smdjeff/pinball-dr-who-wobblehead/README.md

# Dr Who Pinball Moving Dalek Wobble Head Kit

<table><tr>
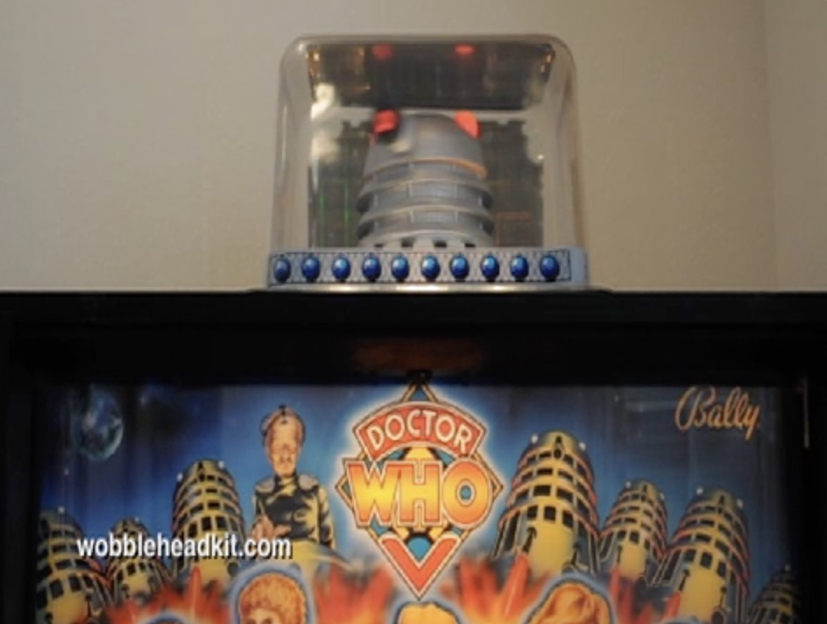
[picture p1: docs/topper.jpg]
    <td style="center"></td>
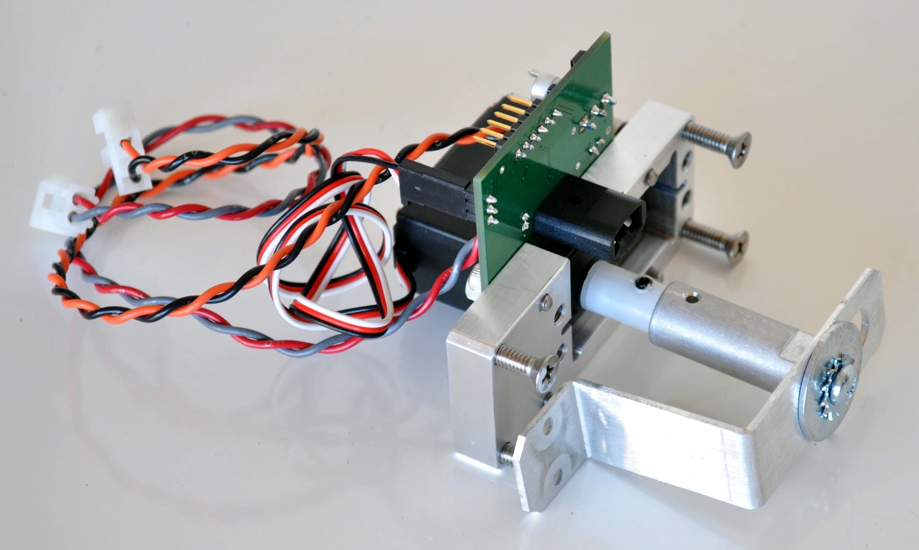
[picture p2: docs/kit.jpeg]
    <td style="center"></td>
</tr></table>
