smdjeff/pinball-dr-who-wobblehead/mechanical/MFP_70267.pdf

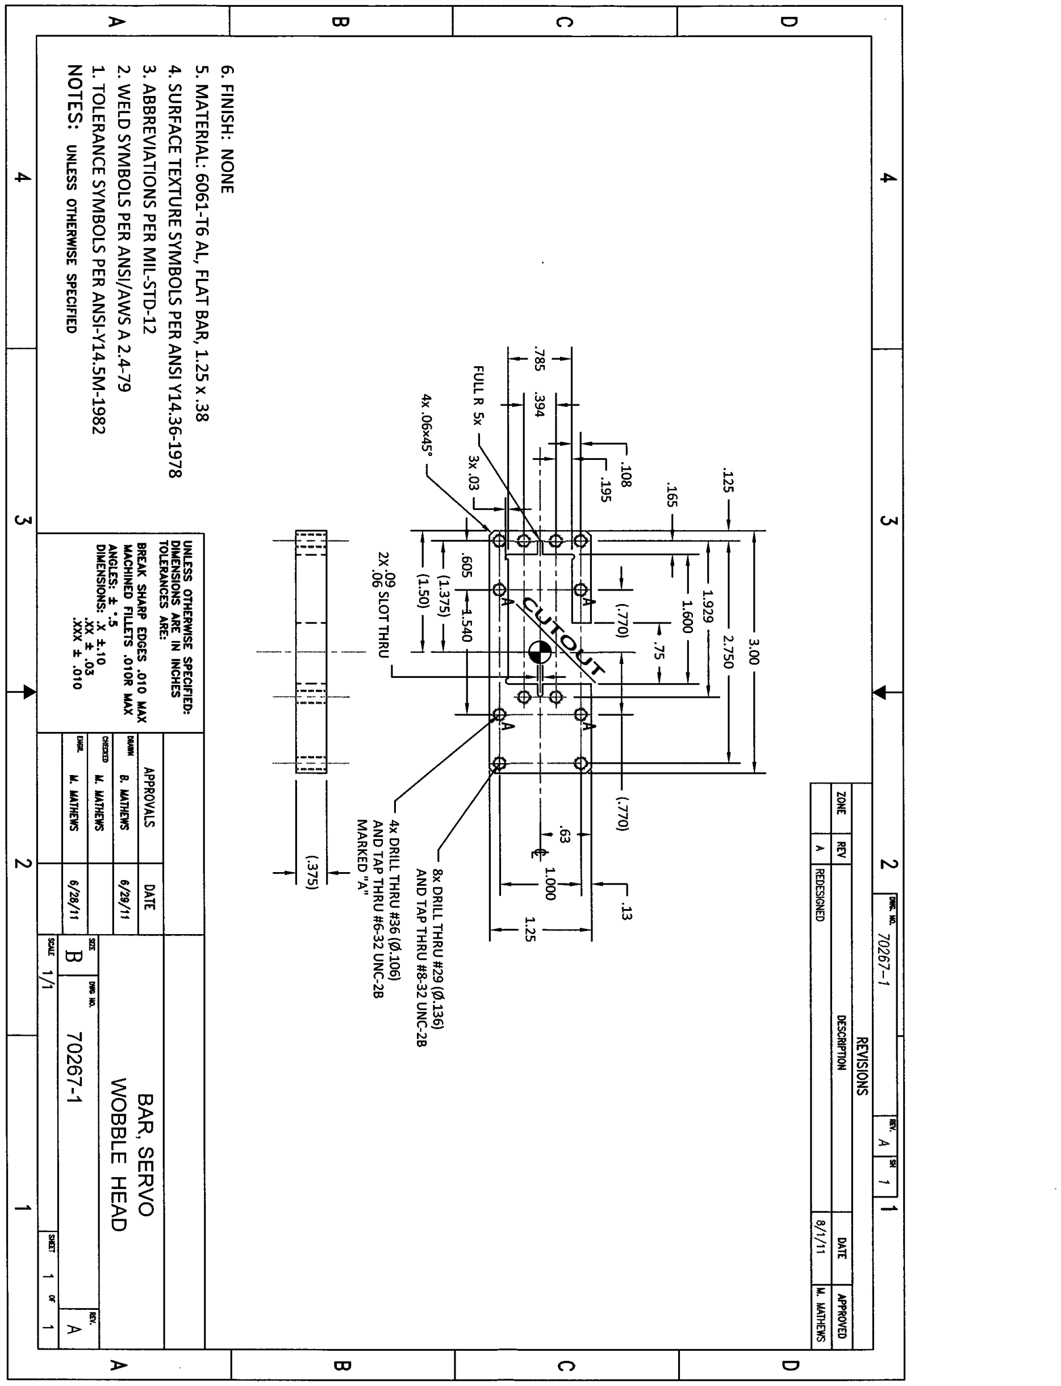
[picture p3: page 1]
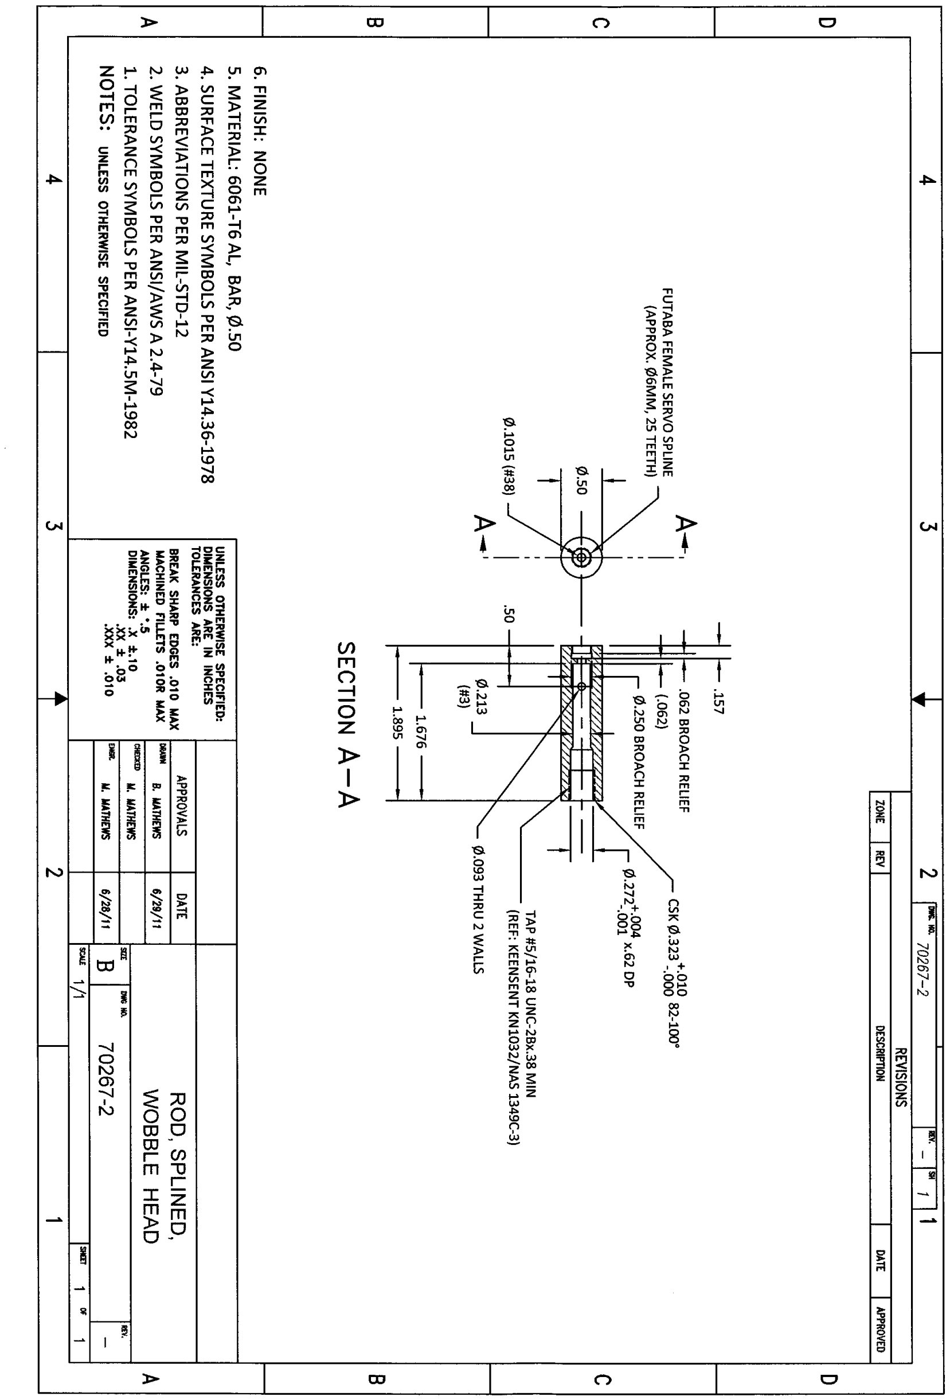
[picture p4: page 2]
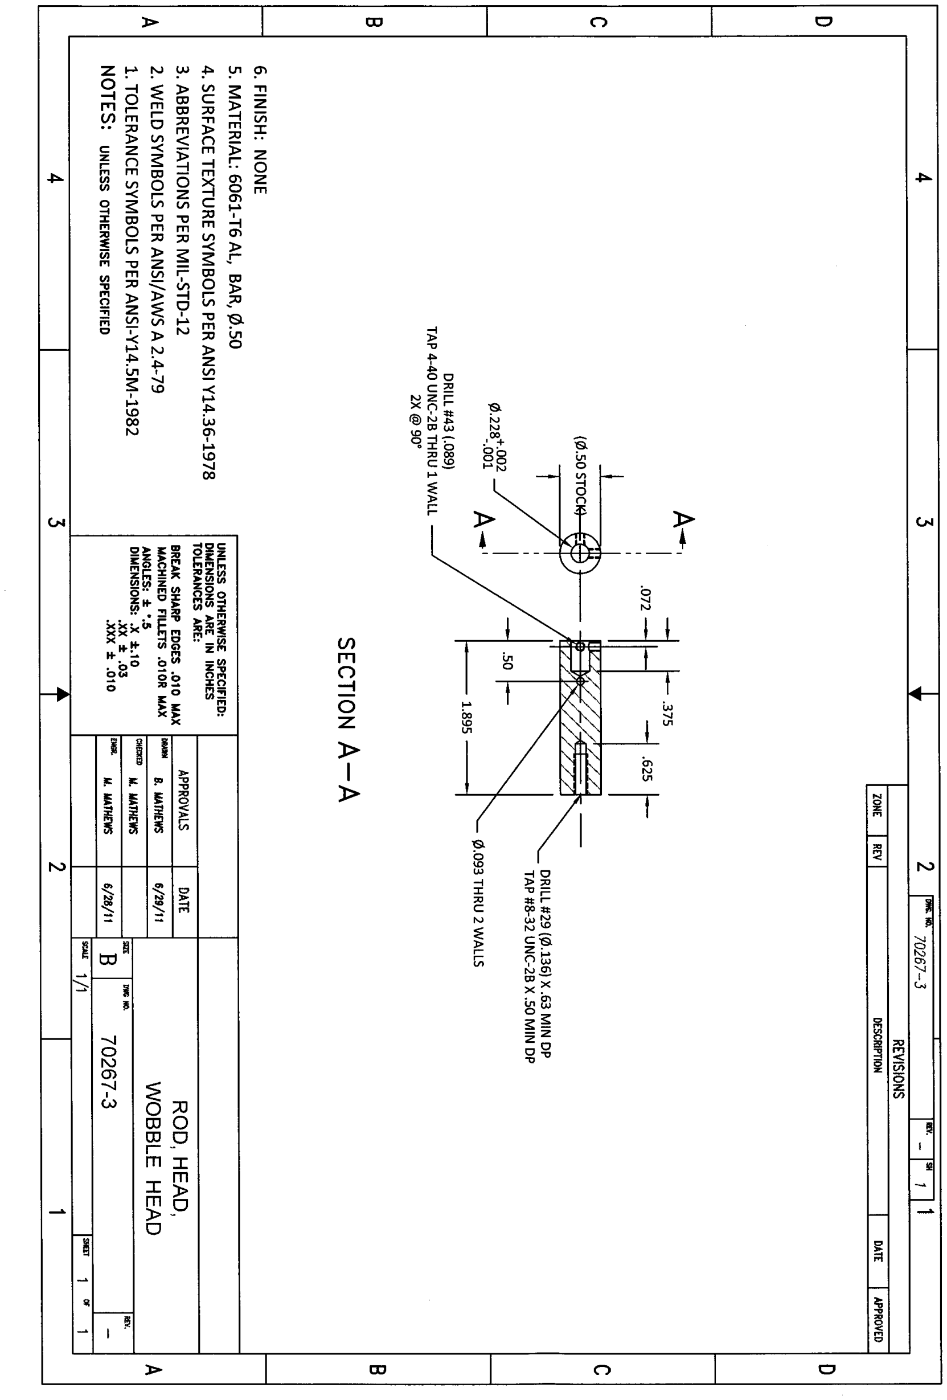
[picture p5: page 3]
