smdjeff/pinball-dr-who-wobblehead/electrical/cables/cables-rev-a.jpg

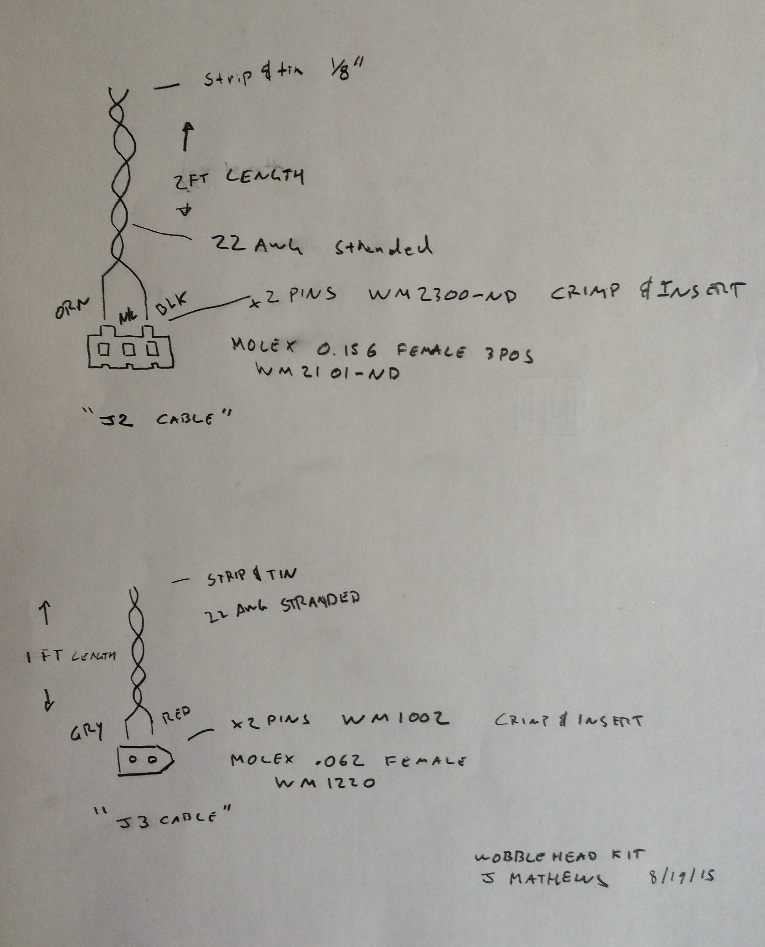
electrical/cables/cables-rev-a.jpg
