smdjeff/pinball-dr-who-wobblehead/electrical/cables/cables-rev-b.jpg

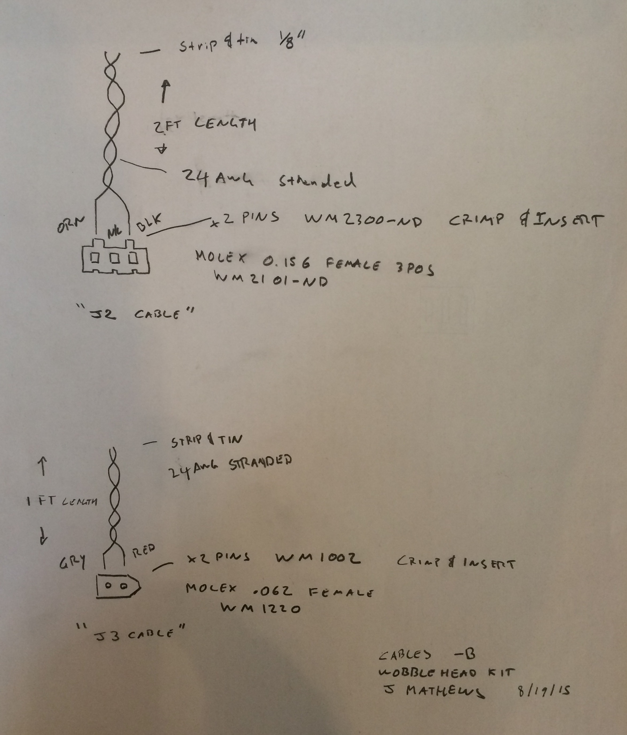
electrical/cables/cables-rev-b.jpg
