smdjeff/pinball-dr-who-wobblehead/mechanical/70267-3c.jpg

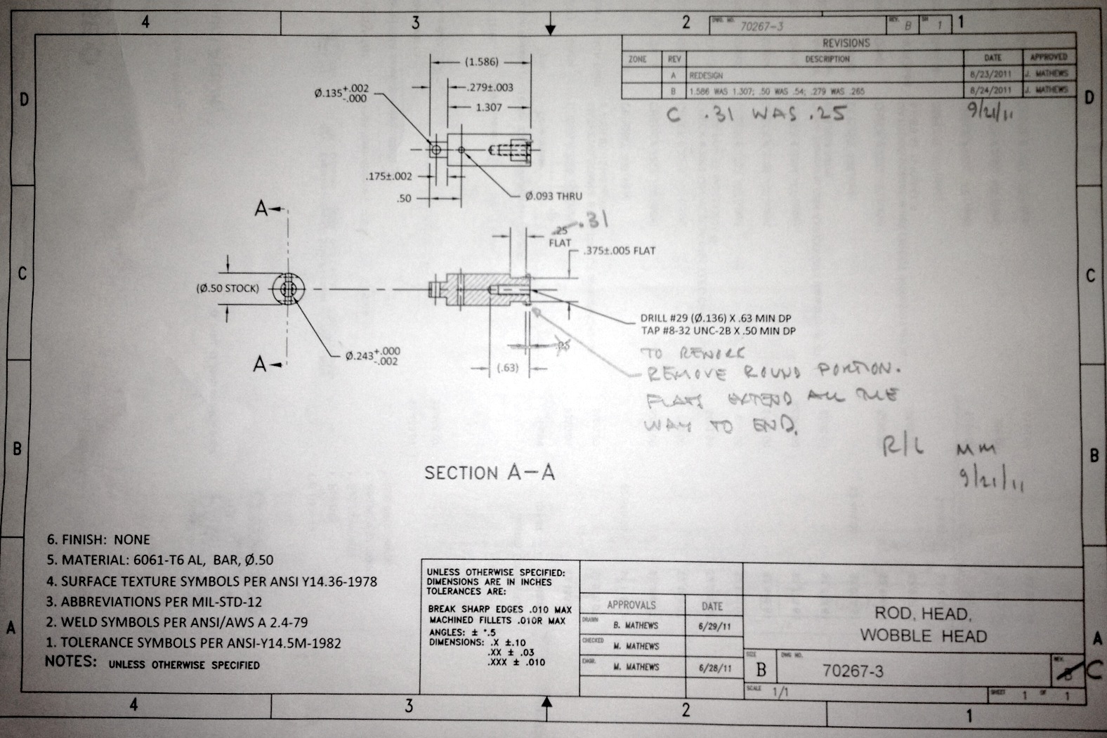
mechanical/70267-3c.jpg
