smdjeff/pinball-dr-who-wobblehead/mechanical/70267-4b.jpg

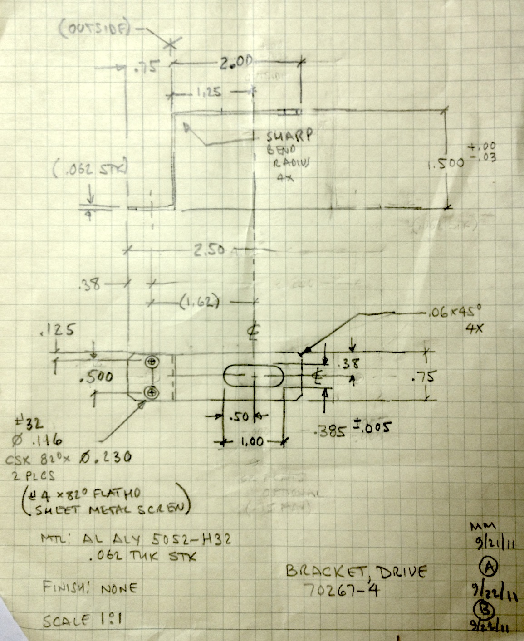
mechanical/70267-4b.jpg
