smdjeff/pinball-dr-who-wobblehead/docs/wobble-head-bom2012.xlsx

Bill Of Materials for wobblehead.sch
Qty | Reference | Desc | Partnumber | Vendor | QTY100 Price | Ext Price
1 | D1 | BAV99 | BAV99-7-F |  | $0.10 | $0.10
0 | D3 | BAV99 | BAV99-7-F |  | $0.10 | $0.00
0 | C4-5 | CAP0805,0.1uF |  |  |  | $0.00
2 | C2, C3 | CAP0805,1.0uF | 311-1358-1-ND |  | $0.03 | $0.06
1 | C1 | CAP SMD55,100uF | 565-2089-1-ND |  | $0.24 | $0.24
1 | U1 | DIODE BRIDGE | CDBHD2100 |  | $1.19 | $1.19
4 | TP1-4 | TEST POINT |  |  |  | $0.00
4 | H1-4 | SCREW | see below |  |  | $0.00
1 | D2 | LED0805 BLUE | 754-1505-1-ND |  | $0.19 | $0.19
1 | J1 | MOLEX1-3POS MALE | WM4601-ND |  | $0.83 | $0.83
1 | TP5 | HEADER SIP 0.1" 6POS | 3M9451-ND |  | $0.19 | $0.19
1 | U3 | PIC10F200 SOT23-6 | PIC10F200 |  | $0.22 | $0.22
1 | R3 | RES0805,100 | 311-100ARCT-ND |  | $0.01 | $0.01
0 | R5 | RES0805,100K | 311-100KARCT-ND |  | $0.01 | $0.00
2 | R1,R7 | RES0805,10k | 311-10KARCT-ND |  | $0.01 | $0.02
1 | R2 | RES0805,1M | 311-1.0MARCT-ND |  | $0.01 | $0.01
0 | R6 | RES0805,6K | 311-6.2KARCT-ND |  | $0.01 | $0.00
1 | U2 | REGULATOR 3.3V 100MA SOT23-6 | TC1055 |  | $0.27 | $0.27
0 | U2 | REGULATOR 5.0V 150mA SOT23-5 | NCP551SN50T1G |  | $0.43 | $0.00
1 | J5 | HEADER SIP 0.1" 3POS | 3M9448-ND |  | $0.14 | $0.14
1 | J2 | MOLEX 0.156 FEMALE 3POS | WM2101-ND |  | $0.83 | $0.83
1 |  | WIRE HARNESS FOR J2 | 24" ORN/BLK |  |  | $0.00
1 | J3 | MOLEX CONN FEMALE 2POS .062 | WM1220 |  | $0.13 | $0.13
0 | J4 | MOLEX CONN MALE 2POS .06 | WM1230 |  | $0.17 | $0.00
1 |  | WIRE HARNESS FOR J3 | 12" GRY/RED | Polarized RED=PIN1 |  | $0.00
3 | J2-PINS | PIN | WM2300-ND |  | $0.08 | $0.24
2 | J3-PINS | PIN | WM1002 |  | $0.08 | $0.16
0 | J4-PINS | PIN | WM1003 |  | $0.07 | $0.00
1 | R4 | RES 0805, 470 OHM | 311-470-RCT-ND |  | $0.01 | $0.01
0 | R4 | RES 0805, 820 OHM | 311-820-RCT-ND |  | $0.01 | $0.00
1 | U4 | OPTO ISO | HMHA2801 |  | $0.33 | $0.33
1 | R8 | RES 1210, 2.2K 1/2W | 541-2.2KVCT-ND |  | $0.14 | $0.14
1 | J6 | WEDGE T3-1/4 LAMP SOCKET PCB | JKL 294502 |  | $0.39 | $0.39
 |  |  |  |  |  | $5.70
1 |  | electronics BOM subtotal from above | various |  | $5.70 | $5.70
1 |  | pcb | 1001-2b | Advanced Assy | $3.50 | $3.50
1 |  | rod, head | 70267-3c | Walt Dimick, IRF Machine Works | $5.00 | $5.00
1 |  | bar, servo, mtg | 70267-1 | Frank Ruiz, Aero Tech Ind | $6.50 | $6.50
1 |  | bracket, drive | 70267-4b | RPM? | $6.00 | $6.00 | estimated cost
1 |  | kimbrough coupler | 500 | Kimbrough | $2.75 | $2.75
1 |  | servo futuba S3003 | YO164B | FocalPrice | $8.97 | $8.97
1 |  | pcb solder stencil |  | Jerry, PCB Stencils | $0.60 | $0.60
1 |  | assembly of pcb and cables |  | Christianna Salaza | $10.00 | $10.00 | approx
4 |  | screw,servo flat #8-32 x 1/2" | 90273A194 |  | $0.04 | $0.14
1 |  | screw,rod pan #8-32 x 1/2" | 90272A194 |  | $0.03 | $0.03
4 |  | screw,bar cap/alan #6-32 x 12" | 92196A148 |  | $0.04 | $0.16
2 |  | screw, bracket flat #4x82deg sheetmetal
2 |  | screw,rod set #?? | ? |  | $0.00 | $0.00
4 |  | screw, servo cap/alan #8-32 x 1/2" | 92196A194 |  | $0.05 | $0.18
4 |  | o-ring, servo 0.1" ID, 1/4" OD | 9452K14 |  | $0.10 | $0.40
0 |  | star-external washer (1/4" ID, 1/2"OD) | 91114A029 |  | $0.03 | $0.00
 |  |  |  |  |  | $49.93
