smdjeff/pinball-dr-who-wobblehead/docs/wobble-head-bom2015.xlsx

Bill Of Materials for wobblehead.sch
Qty | Reference | Desc | Partnumber | Vendor | QTY100 Price | Ext Price
1 |  | Electronics BOM | various | Chris Dalla | $4.00 | $4.00
1 |  | PCB |  | Chris Dalla | $3.00 | $3.00
1 |  | PCB and cable Assembly |  | Chris Dalla | $10.00 | $10.00
1 |  | Servo Rod | 70267-3c | Walt Dimick, IRF Machine Works | $5.00 | $5.00
1 |  | Servo Bar | 70267-1 | 3D Printed | $5.00 | $5.00
1 |  | L Bracket | 70267-4b | 3D Printed | $5.00 | $5.00
1 |  | Kimbrough coupler | 500 | Kimbrough | $2.75 | $2.75
1 |  | servo futuba S3003 | YO164B | FocalPrice | $8.97 | $8.97
4 | bar to servo | screw, cap head #8-32 x 3/8" SS | 92196A192 |  | $0.06 | $0.25
2 | pcb to bar | screw, cap head #6-32 x 3/8" SS | 92196A146 |  | $0.05 | $0.11
4 | bar to body | screw, flat head #8-32 x 1/2" | 90273A194 |  | $0.04 | $0.14
2 | brack to head | screw, flat #4 x 1/2" 82deg sheet metal | 90048A110 |  | $0.02 | $0.04
1 | rod to head | screw, pan head #8-32 x 1/2" | 90272A194 |  | $0.03 | $0.03
2 | coupler | set screw |  | Included with Kimbrough | $0.00 | $0.00
1 | servo to coupler | pan head |  | Included with servo | $0.00 | $0.00
 |  |  |  |  |  | $44.28
