smdjeff/pinball-dr-who-wobblehead/installation/dr-who-pinball-dalek-topper-wobble-head-kit-DSC_3973.JPG

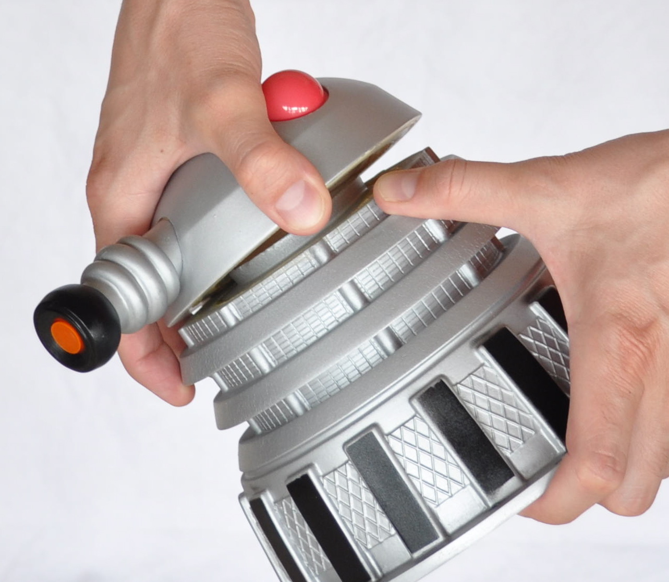
installation/dr-who-pinball-dalek-topper-wobble-head-kit-DSC_3973.JPG
