smdjeff/pinball-dr-who-wobblehead/installation/dr-who-pinball-dalek-topper-wobble-head-kit-DSC_4122.JPG

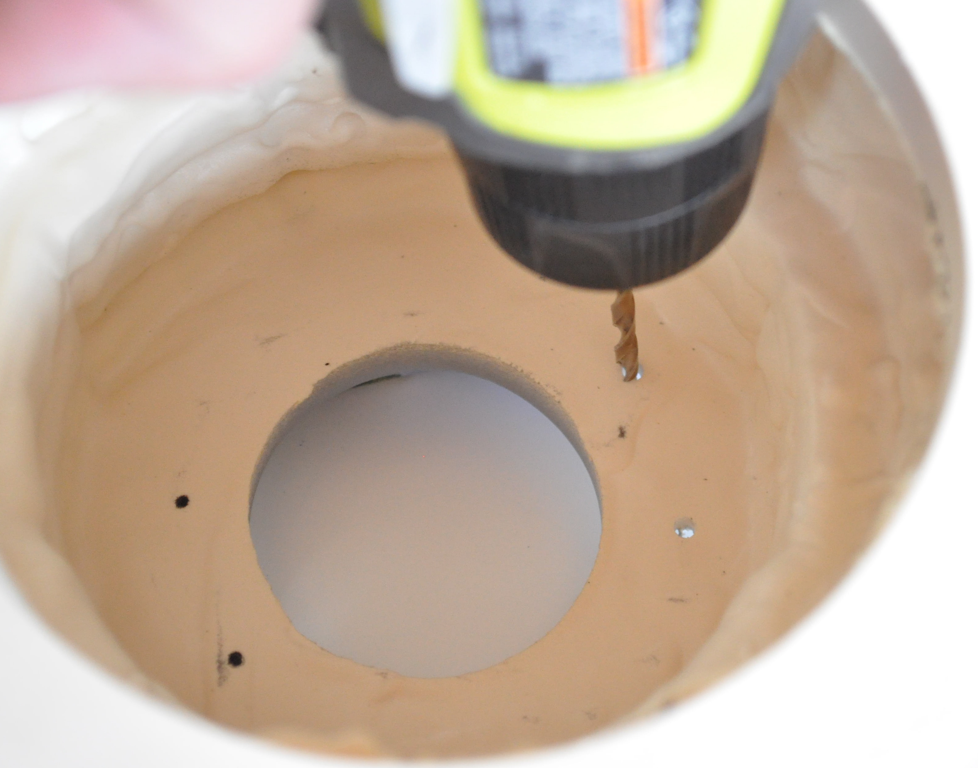
installation/dr-who-pinball-dalek-topper-wobble-head-kit-DSC_4122.JPG
