smdjeff/pinball-dr-who-wobblehead/installation/dr-who-pinball-dalek-topper-wobble-head-kit-DSC_4152.JPG

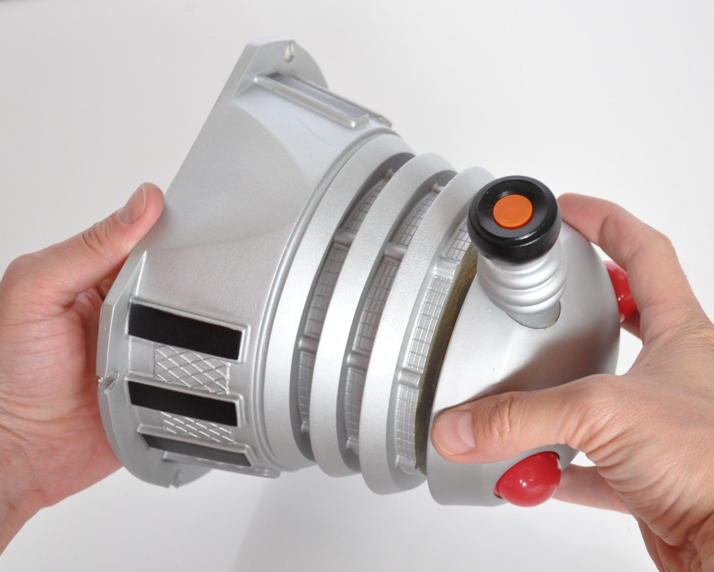
installation/dr-who-pinball-dalek-topper-wobble-head-kit-DSC_4152.JPG
