smdjeff/pinball-dr-who-wobblehead/electrical/rev2/TestIntegrity.txt

PADS Router. Database Integrity Test results for <C:\PADS Projects\wobblehead_blz-routed-2.pcb>

No database integrity problems found.
