smdjeff/pinball-dr-who-wobblehead/electrical/rev2/wobblehead_blz-routed-poured-2.pdf

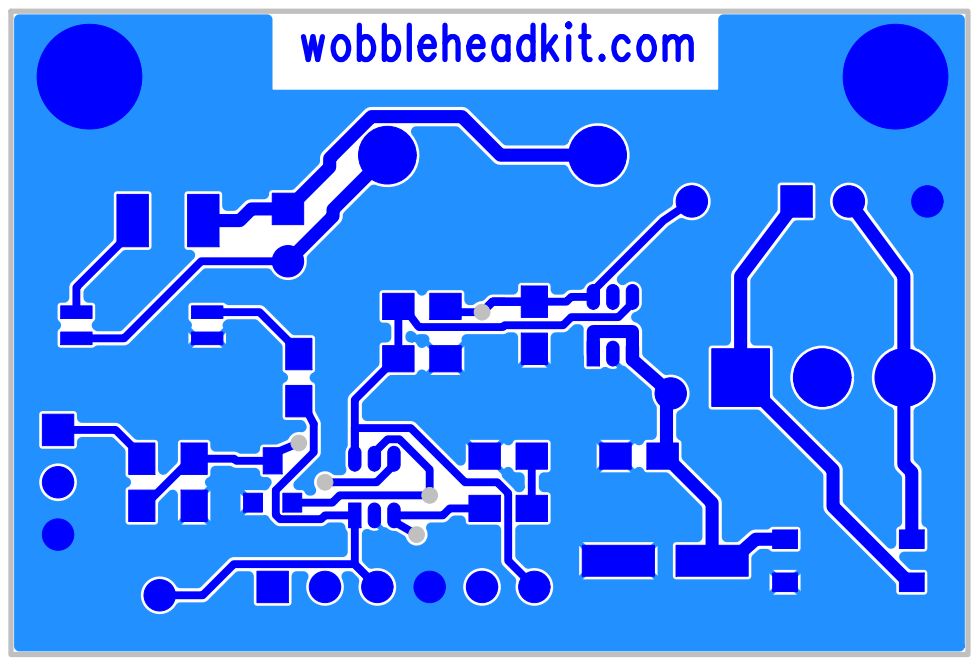
[picture p35: page 1]
wobbleheadkit.com; R7R⁷x1 R⁷x2; U1U¹x1 U¹x3; U¹x2 U¹x4 J1J1x1 J1x2 J1x3; R1R¹x1; R¹x2 C1C¹x2; C¹x1; TP3TP³x1; TP2TP²x1; TP4TP⁴x1; U2U²x1 Ux2 U²x3 U²x6 U²x5 U²x4; C2C²x1 C²x2; R2R²x1; R²x2; C3C³x1; C³x2; U3U³x1 Ux2 U³x3 U³x6 U³x5 U³x4; C4C⁴x1; R3R³x1; D1D¹x1; D¹x2 D¹x3; R4R⁴x2; R⁴x1 J5x1 J5x2 J5x3; TP5 TP⁵x1; TP⁵x2; TP⁵x3; TP⁵x4; TP⁵x5; TP⁵x6; D2D²xK; D²xA; H1H¹x1; H2H²x1; U4U⁴x1 U⁴x2; U⁴x3 U⁴x4; R8R⁸x1; R⁸x2; TP1TP¹x1

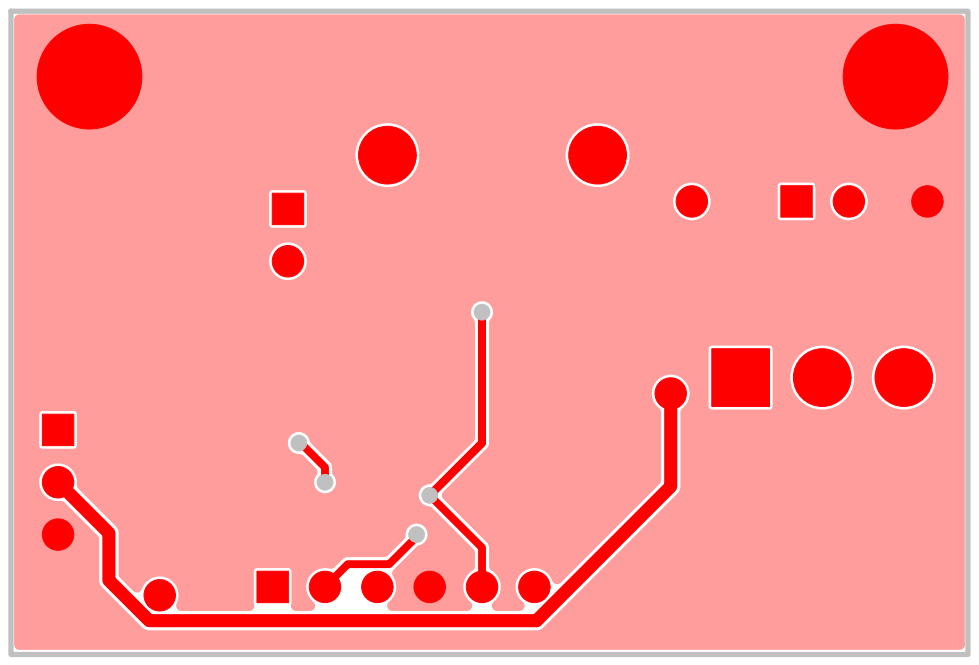
[picture p36: page 2]
TP3TP³x1; TP2TP²x1; TP4TP⁴x1; TP5 TP⁵x1; TP⁵x2; TP⁵x3; TP⁵x4; TP⁵x5; TP⁵x6; H1H¹x1; H2H²x1; TP1TP¹x1

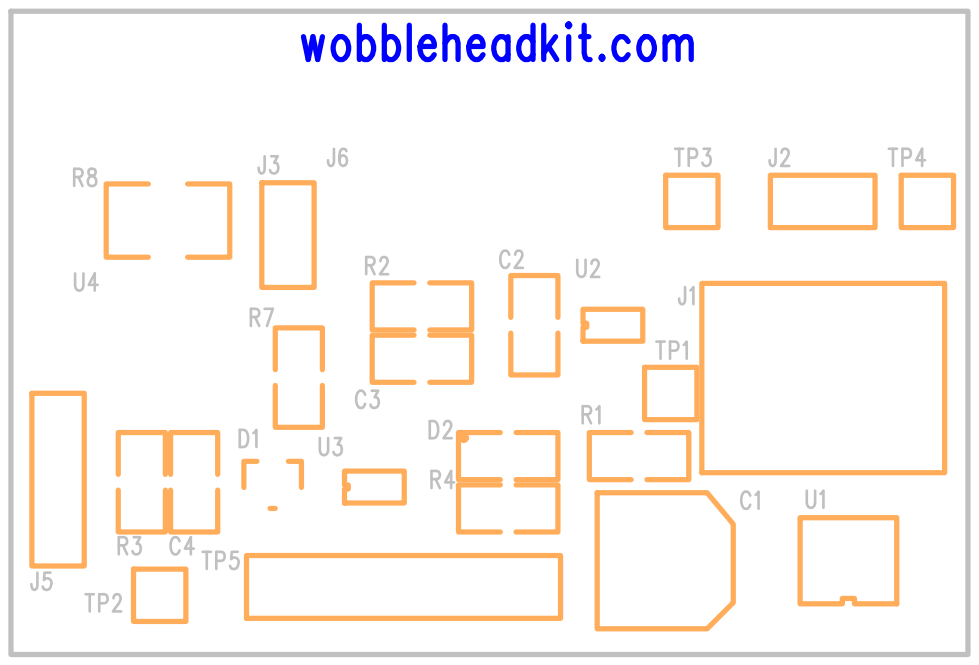
[picture p37: page 3]

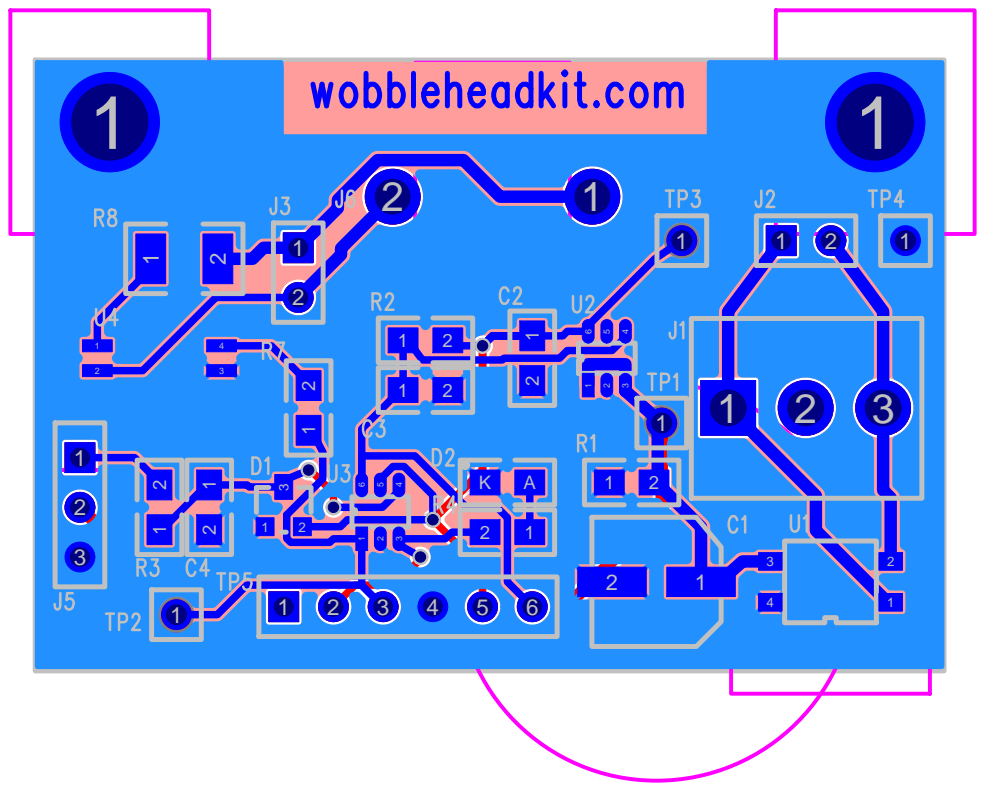
[picture p38: page 5]
