smdjeff/pinball-dr-who-wobblehead/electrical/rev2/wobblehead_sch-2.pdf

D

6 | 5 | 4 | 3 | 2 | 1

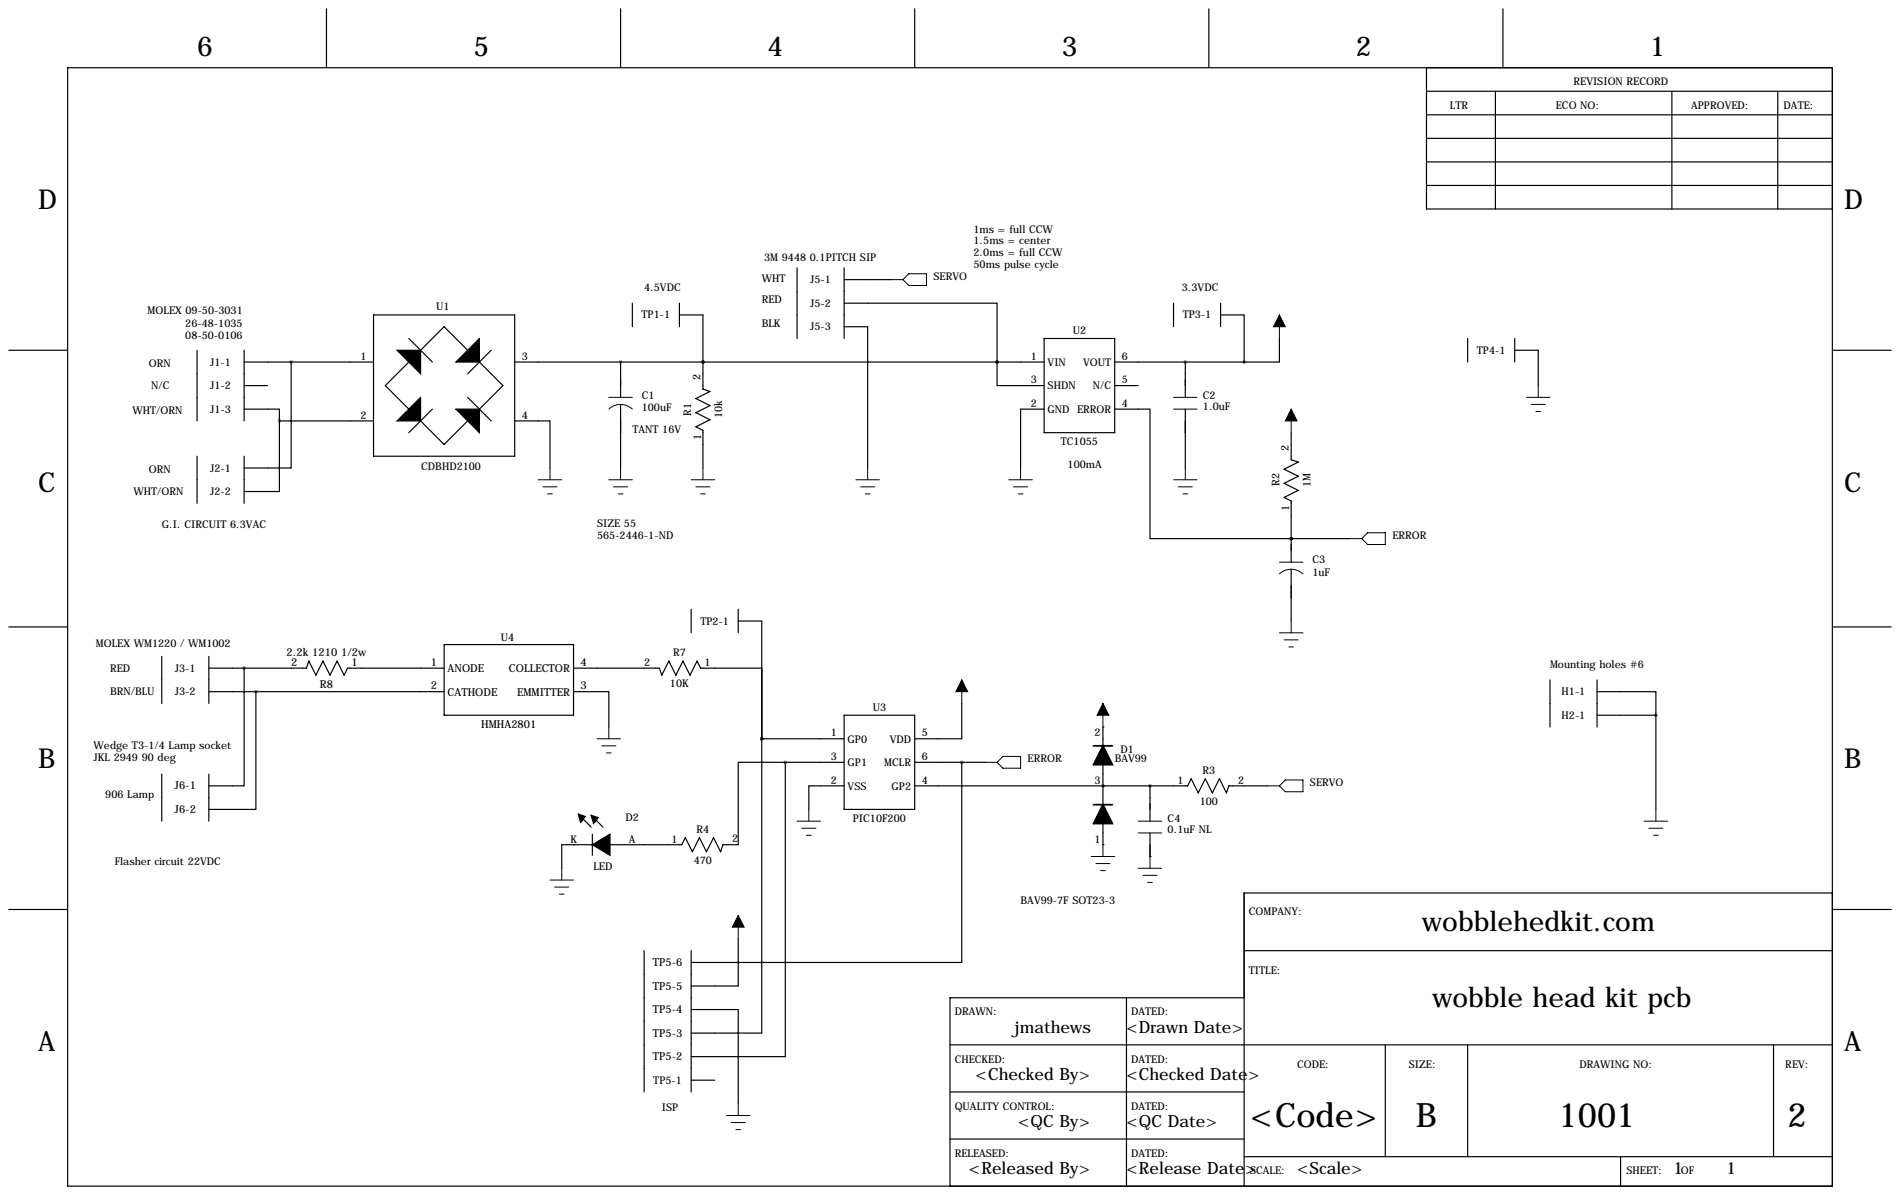
[picture p39: page 1]

1ms = full CCW 1.5ms = center 2.0ms = full CCW 3M 9448 0.1PITCH SIP 50ms pulse cycle | REVISION RECORD

LTR | ECO NO: | APPROVED: | DATE:

wobble head kit pcb

DRAWN: jmathews | DATED: <Drawn Date>
CHECKED: <Checked By> | DATED: <Checked Date> | CODE: <Code> | SIZE: B | DRAWING NO: 1001 | REV: 2

QUALITY CONTROL: <QC By> | DATED: <QC Date>

RELEASED: <Released By> | DATED:

<Scale> SCALE: | 1 1 SHEET: OF
