smdjeff/pinball-dr-who-wobblehead/electrical/rev1/wobblehead_blz_pour_1to1.pdf

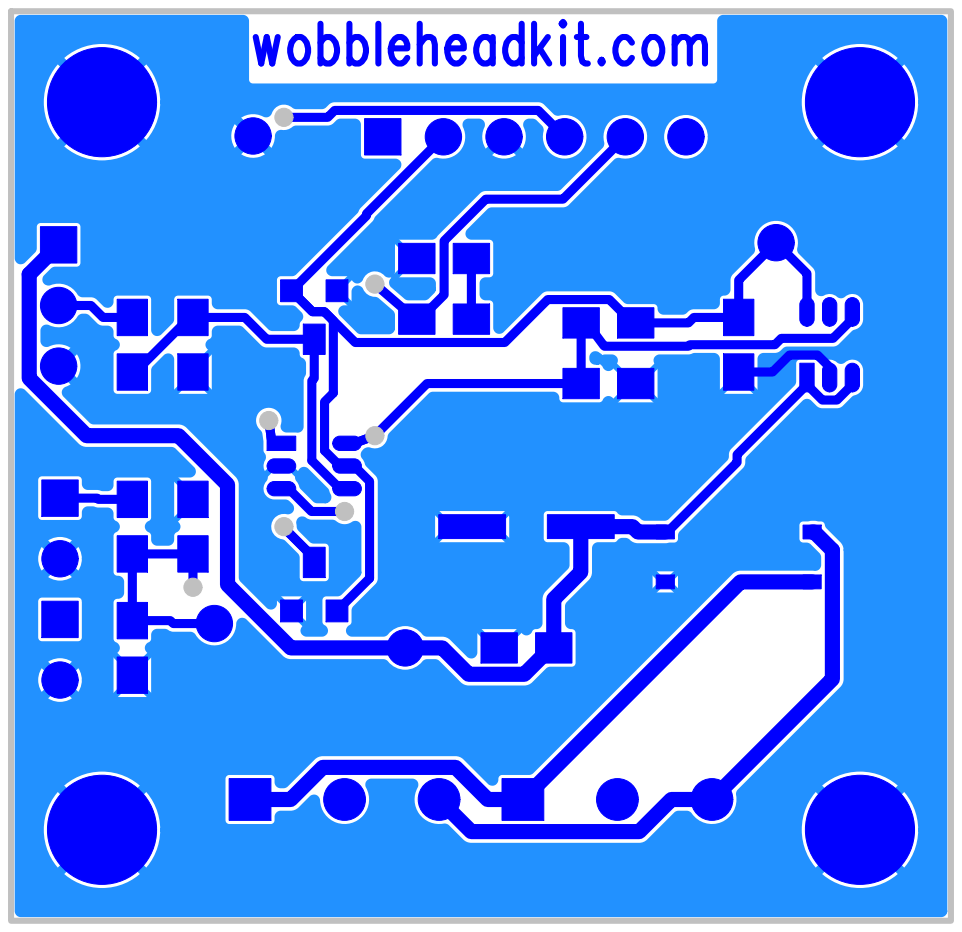
[picture p49: page 1]
wobbleheadkit.com; C5C⁵x1 C⁵x2; R5R⁵x1 R⁵x2; D3D³x1; D³x2 D³x3; U1U¹x1 U¹x3; U¹x2 U¹x4; C1R1R¹x1; R¹x2 C¹x2; C¹x1; TP1TP¹x1; TP3TP³x1; TP2TP²x1; TP4TP⁴x1; U2U²x1 Ux2 U²x3 U²x6 U²x5 U²x4; C2C²x1 C²x2; R2R²x1; R²x2; C3C³x1; C³x2; U3U³x1 U³x2 U³x3; U³x4 U³x5 U³x6; C4C⁴x1; R3R³x1; D1D¹x2; D¹x1 D¹x3; R4R⁴x2; R⁴x1; R6R⁶x1 R⁶x2; TP5 TP⁵x1; TP⁵x2; TP⁵x3; TP⁵x4; TP⁵x5; TP⁵x6; D2D²xK; D²xA; H1H¹x1; H2H²x1; H3H³x1; H4H⁴x1

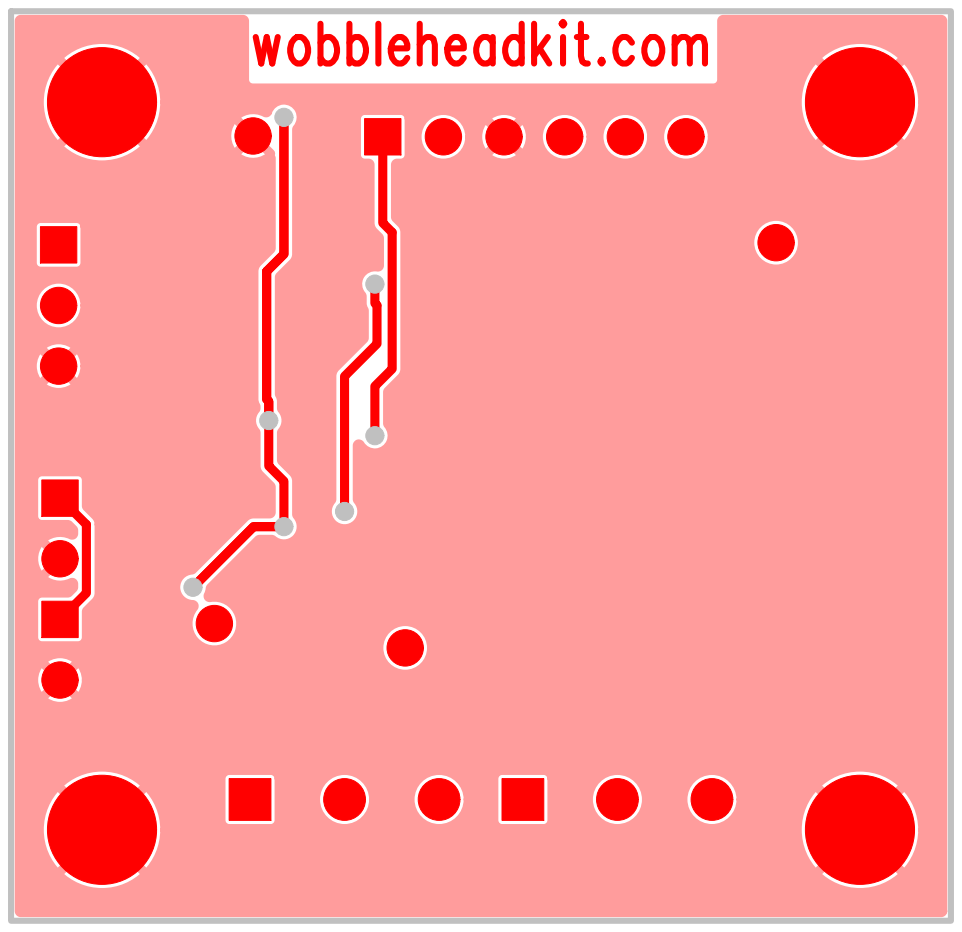
[picture p50: page 2]
wobbleheadkit.com; TP1TP¹x1; TP3TP³x1; TP2TP²x1; TP4TP⁴x1; TP5 TP⁵x1; TP⁵x2; TP⁵x3; TP⁵x4; TP⁵x5; TP⁵x6; H1H¹x1; H2H²x1; H3H³x1; H4H⁴x1

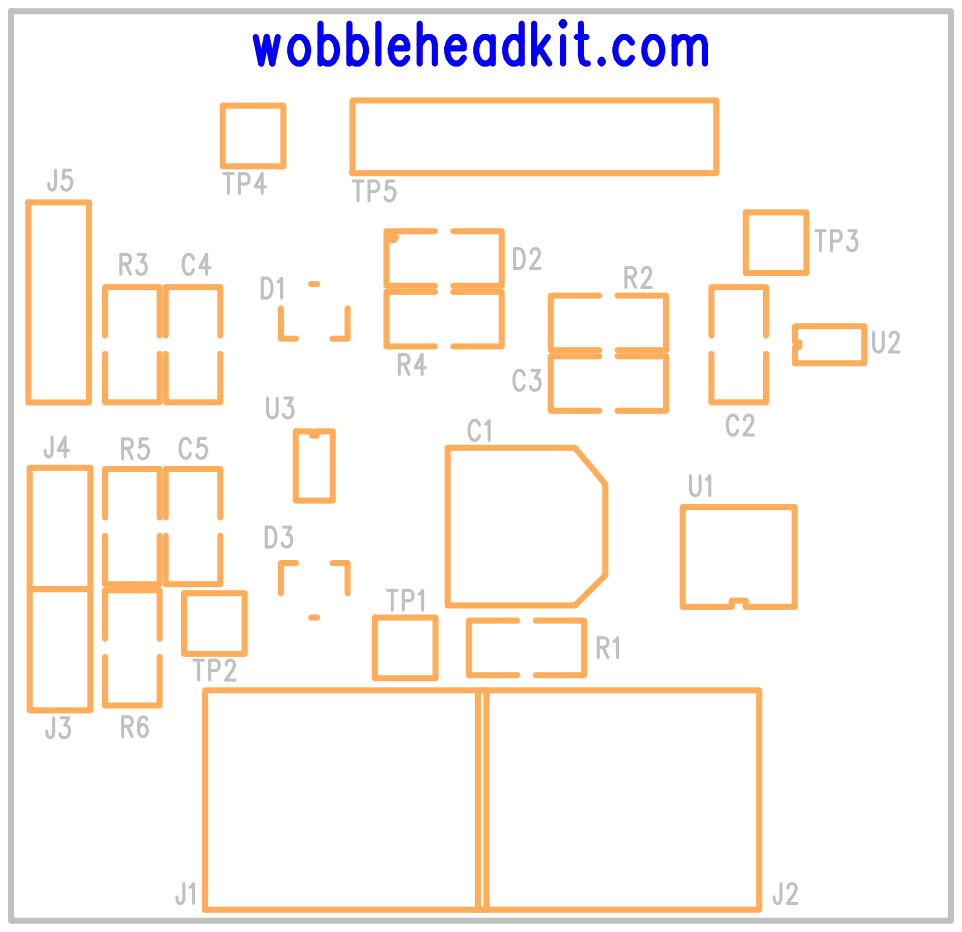
[picture p51: page 3]

# wobbleheadkit.com

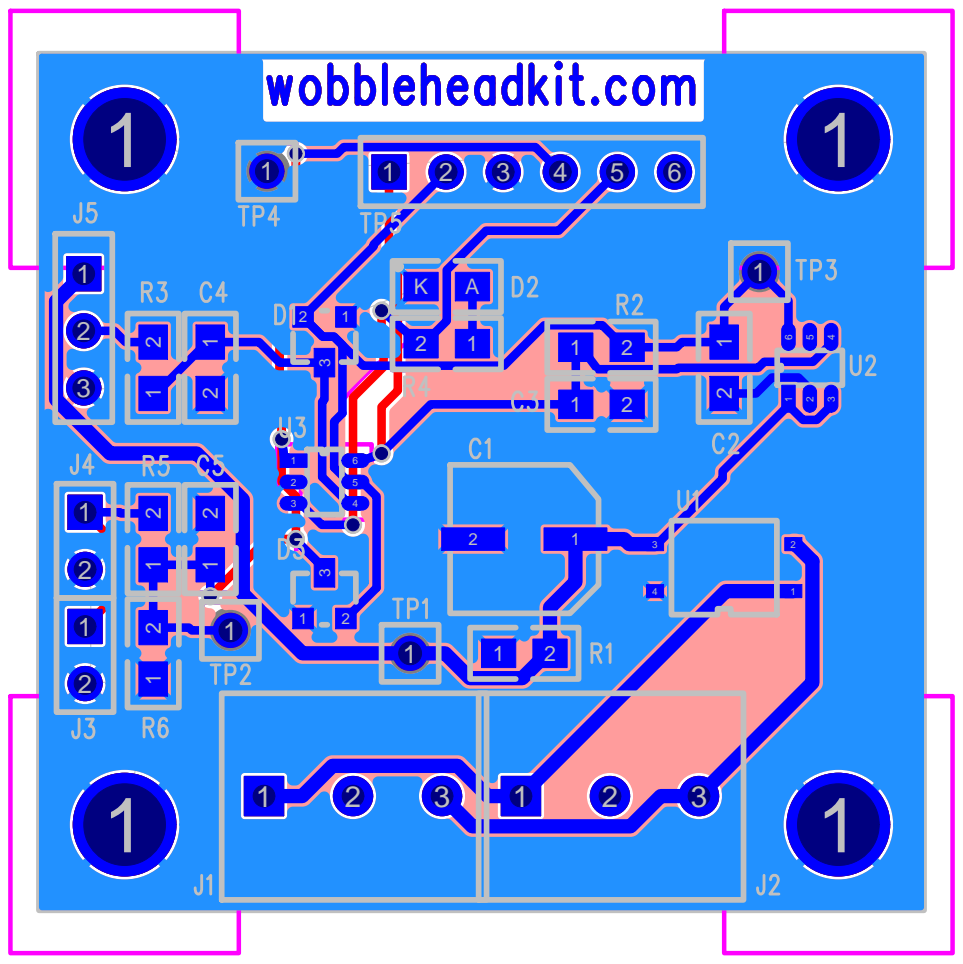
[picture p52: page 5]
