smdjeff/pinball-dr-who-wobblehead/(list of files, drawings)

Other design files:
electrical/rev1/wobblehead.pcb
electrical/rev1/wobblehead_blz1.pcb
electrical/rev1/wobblehead_blz.pcb
electrical/rev1/wobblehead_blz_pour.pcb
electrical/rev2/Layou1.pcb
electrical/rev2/Layou2.pcb
electrical/rev2/Layou3.pcb
electrical/rev2/Layout.pcb
electrical/rev2/wobblehead_blz1.pcb
electrical/rev2/wobblehead_blz-2.pcb
electrical/rev2/wobblehead_blz.pcb
